FelipeFFerreira/ITA-CORES/docs/fig_7.png

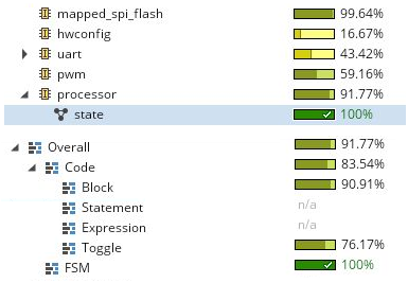
docs/fig_7.png
