FelipeFFerreira/ITA-CORES/docs/fluxo_automatizado.png

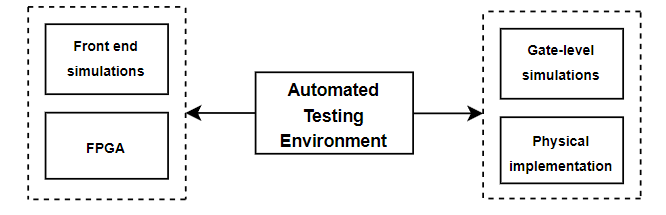
docs/fluxo_automatizado.png
