FelipeFFerreira/ITA-CORES/docs/log.png

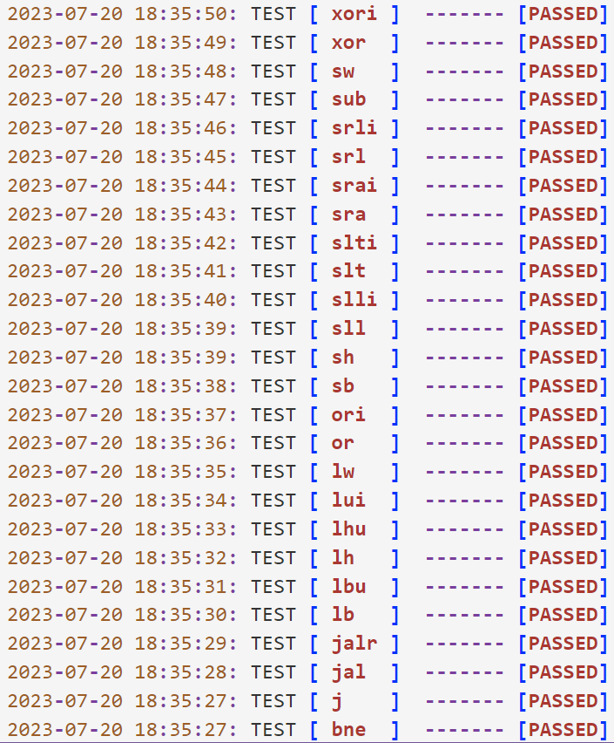
docs/log.png
