FelipeFFerreira/ITA-CORES/docs/pcb_jlcpcb.png

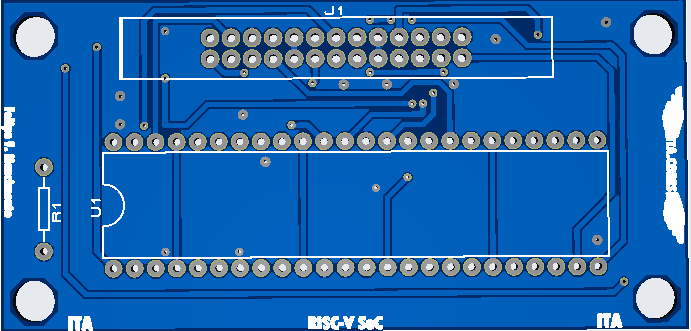
docs/pcb_jlcpcb.png
