FelipeFFerreira/ITA-CORES/docs/pwm_simu.png

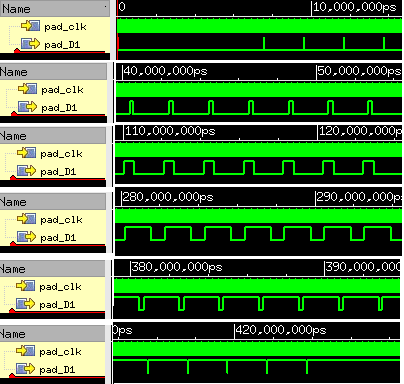
docs/pwm_simu.png
