FelipeFFerreira/ITA-CORES/docs/simulacao_gerada.png

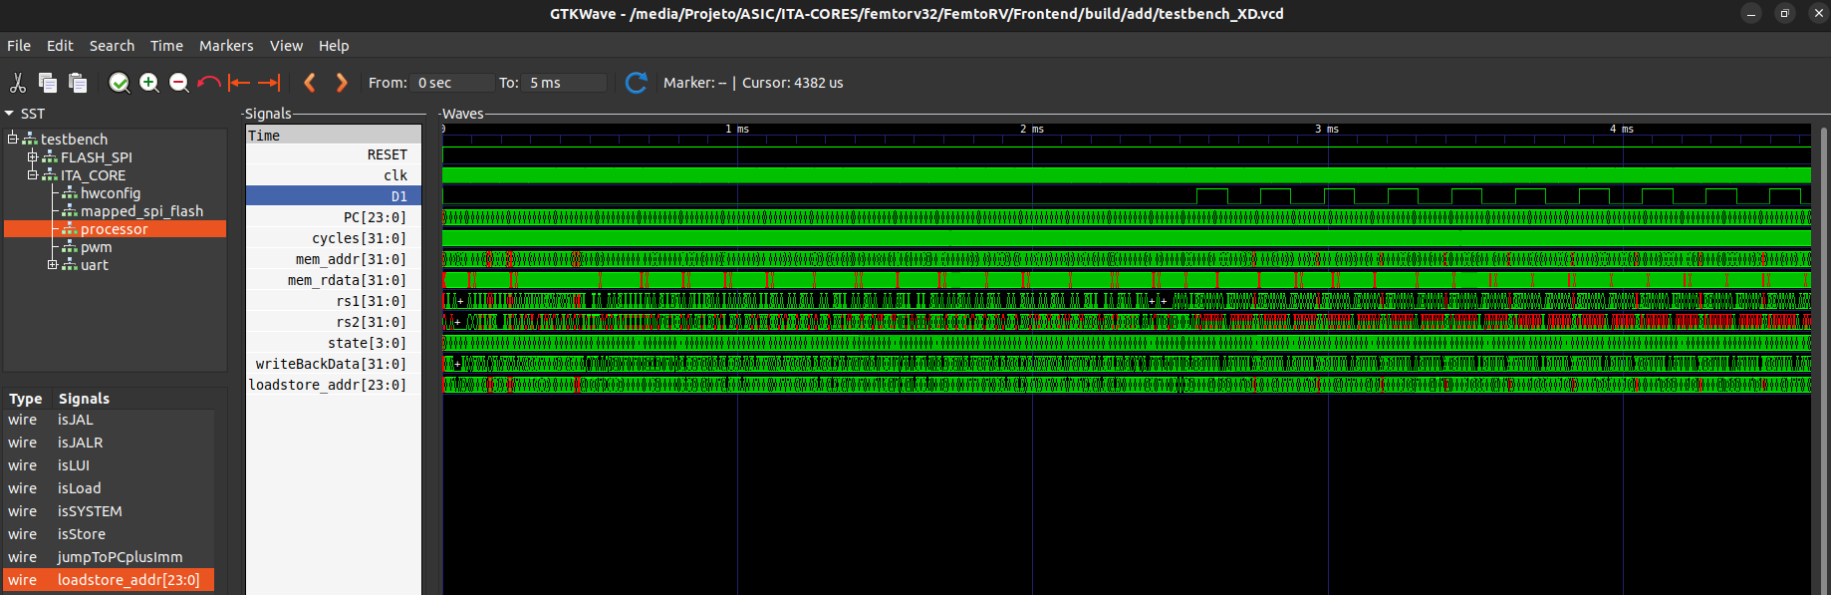
docs/simulacao_gerada.png
