FelipeFFerreira/ITA-CORES/SoC_and_ASIC_Projects/Environment-Validation-Chip/spi_interface/PINAGE_PCB-ICESUGAR.png

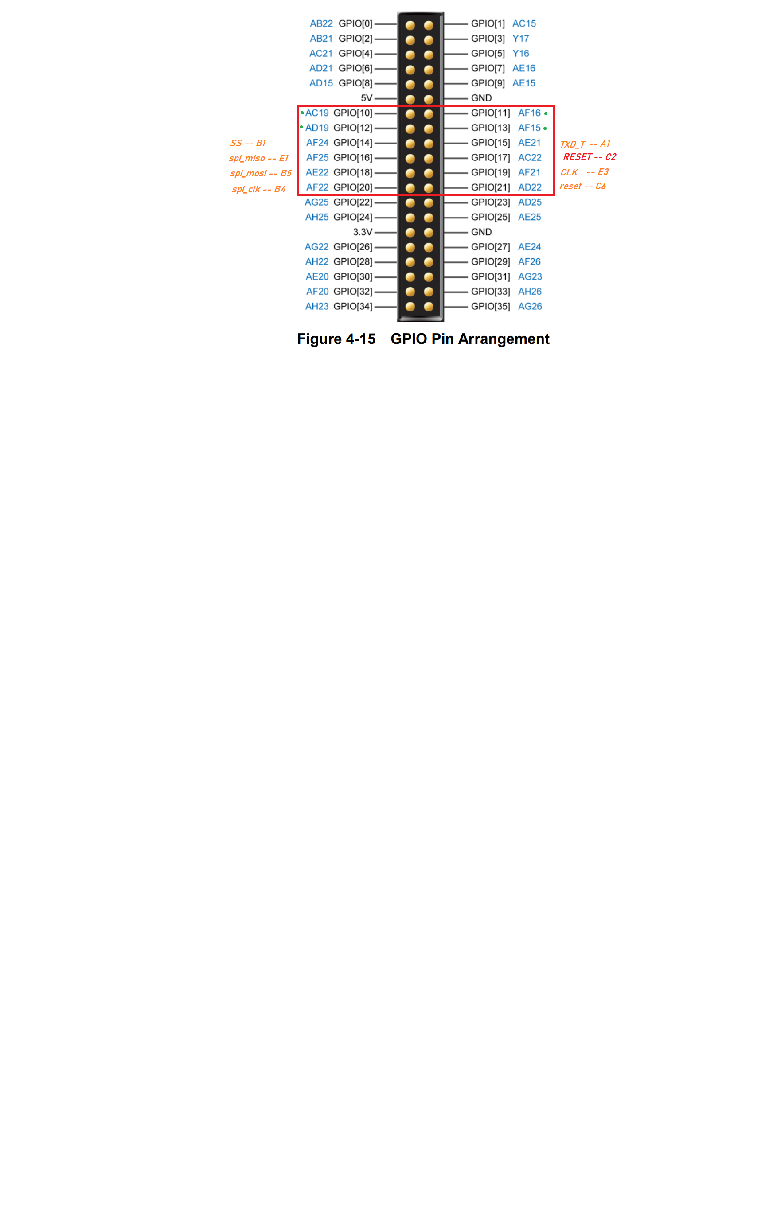
SoC_and_ASIC_Projects/Environment-Validation-Chip/spi_interface/PINAGE_PCB-ICESUGAR.png
