FelipeFFerreira/ITA-CORES/SoC_and_ASIC_Projects/femtorv32/FemtoRV/BOARDS/icesugar_nano.pcf

set_io clk D1

set_io TXD B3
set_io RXD A3

set_io D1 B6

#TEST-SPI
# set_io spi_cs_n E3 #roxo
# set_io spi_miso B5 #preto
# set_io spi_mosi C6 #branco
# set_io spi_clk  B4 #preto dan

set_io spi_cs_n D5
set_io spi_miso F5
set_io spi_mosi E4
set_io spi_clk  E5

set_io RESET    C5
