FelipeFFerreira/ITA-CORES/SoC_and_ASIC_Projects/femtorv32/FemtoRV/Frontend/test-programs/logo-ita/main.c

#include <femtorv32.h>

int main()
{
	unsigned int i = 0;
	while (1) {
		
		i += 2;
		printf("%d. [ITA-RVITA]\r\n", i++);
		printf("Freq: %d MHz\r\n", FEMTORV32_FREQ);
		*(volatile uint32_t*) (0x400004) = 1;
		delay(200);
		*(volatile uint32_t*) (0x400004) = 0;
		delay(200);
		printf(" ** Testando - UART! [ITA_CORES] ***\r\n");
		printf("Freq: %d MHz\r\n", FEMTORV32_FREQ);
		delay(200);
		for (unsigned int i = 0; i < 10; i++) {
			if (i < 2) printf("\t***\t**************\t***********");
			else  printf("\t***\t     ****\t***\t***");
			if (i == 4) printf("\n\t***\t     ****\t***********");
			printf("\n");
   		}
	}
	
	return 0;
}
