FelipeFFerreira/ITA-CORES/(commit log)

2022-10-14 fix problems for synthesis in ASC
    [femtosoc.v, testbench.v]
2022-11-02 testbench SPI
2022-11-02 spi - tests load mem
2022-11-03 module pwm
2022-11-22 device pwm
2022-11-27 tests spi
2022-12-20 fix reset - metastability
    [femtosoc.v, icesugar_nano.pcf, main.c, testbench.v]
2023-05-25 fix linker. tests running directly to the core
    [femtosoc.v, testbench.v]
2023-05-25 implemented verification of success or failure of tests
    [testbench.v]
2023-05-25 fix len vector elf-tool
    [tool-elf.c]
2023-05-30 fix spi protocol
2023-06-04 automates tests to run on the device
2023-06-14 init best test flow for device
2023-06-14 Validates the interaction between the entire flow environment
2023-06-18 fix bug linker and start
    [femtorv32_electron.v, femtorv32_quark.v, femtosoc.v, testbench.v]
2023-10-01 Updates delay time for tests with the PWM peripheral
2023-10-01 Add new pwm version dedicated to general purpose programs
2023-10-01 Add new README for framework-related documentation
2023-10-01 Modifies SPI test interface for integration with reset logic with the RISC-V SoC
2023-10-01 Updates pin mapping for compatibility with reset logic integrated into the SPI test interface
    [flash_spi.v, io.pcf]
2023-10-01 remove debug prints to test the elf-verilog implementation
2023-10-04 update readme with information to use the framework
2023-10-04 updates readme with detailed information about the developed framework
2023-10-04 Add gif exemplifying how the framework works
2023-10-06 refactors framework structure to improve readability
2023-10-06 fix path to toolchain in the framework's main makefile
